ksarkies/Watermeter-TestBench/Documentation/Watermeter-Interface-Card.jpg

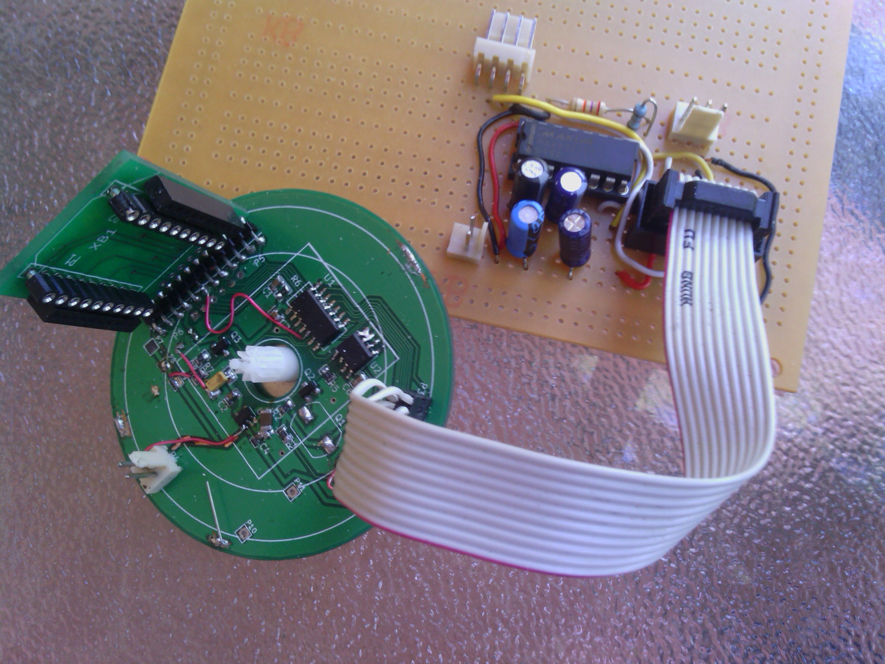
Documentation/Watermeter-Interface-Card.jpg
