ksarkies/Watermeter-TestBench/Documentation/MAX31865-Arduino-Connection.jpg

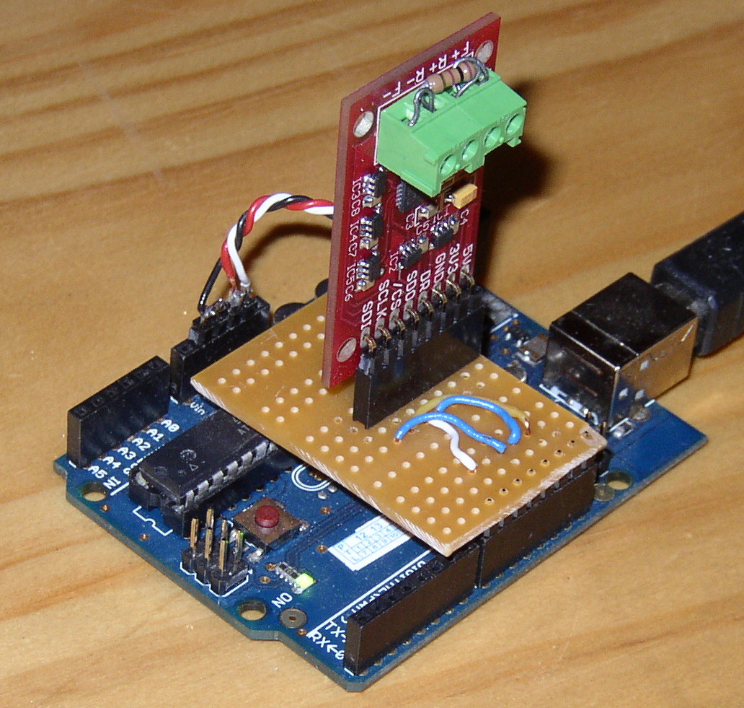
Documentation/MAX31865-Arduino-Connection.jpg
