ksarkies/Watermeter-TestBench/flowbench-firmware-Arduino/README.md

Watermeter Testbench Firmware
=============================

This is the Arduino firmware for the testbench experiments.

* Flow meter FS200A, 450 counts/litre, 25 litres/minute max, pulse rate 188Hz max.
Connect three pin plug (black = gnd, red = 5V, white = signal) to header 3 of
the Arduino Sensor Shield.

* Pressure sensor unknown. 0.5V - 4.5V for 0MPa - 1.2MPa.
Connect three pin plug (black = gnd, red = 5V, white = signal) to header A0 of
the Arduino Sensor Shield.

* Temperature sensor PT50 platinum wire plus bridge to current loop 4-20mA.
Connect grounds and two signal wires to the MAX31865 board. 

* Start switch normally high, momentarily low.
Connect three pin plug (black = gnd, red = 5V, white = signal) to header 4 of
the Arduino Sensor Shield.

* Solenoid 2W-200-20 high is off, low is on.
Connect three pin plug (black = gnd, red = 5V, white = signal) to header 5 of
the Arduino Sensor Shield.

* Water meter.
Connect three pin plug (black = gnd, red = 5V, white = signal) to header 6 of
the Arduino Sensor Shield.

K. Sarkies, 26/2/2015
