ksarkies/Watermeter-TestBench/Documentation/Arduino.jpg

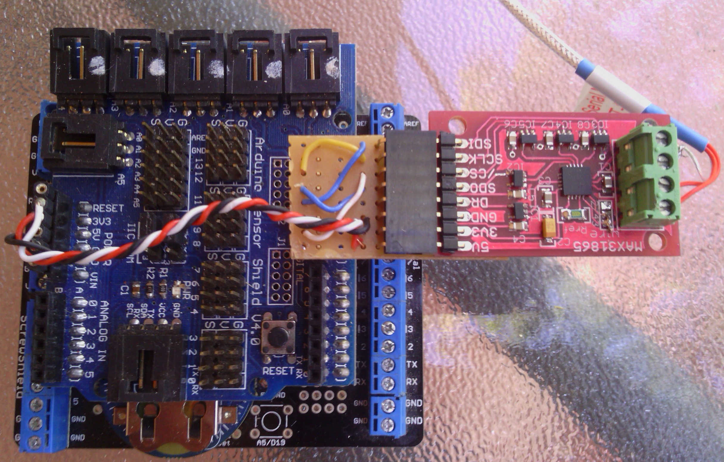
Documentation/Arduino.jpg
