ksarkies/Watermeter-TestBench/Documentation/flowbench-gui-1.png

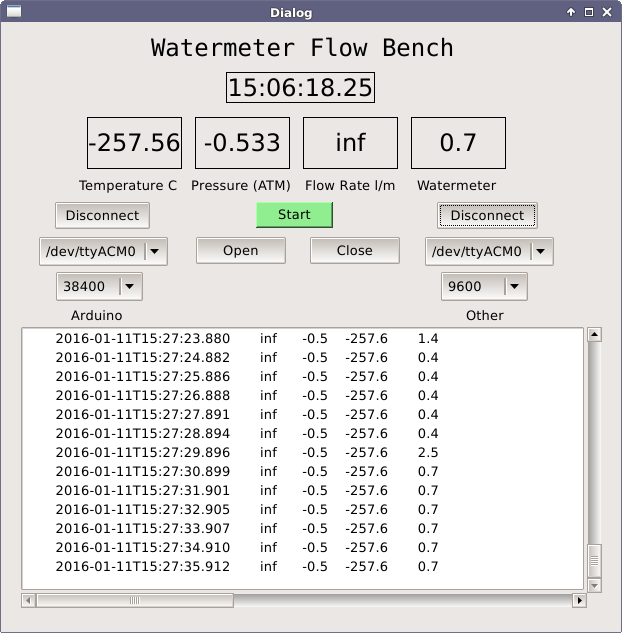
Documentation/flowbench-gui-1.png
