ksarkies/Watermeter-TestBench/Documentation/interface-card-bottom.jpg

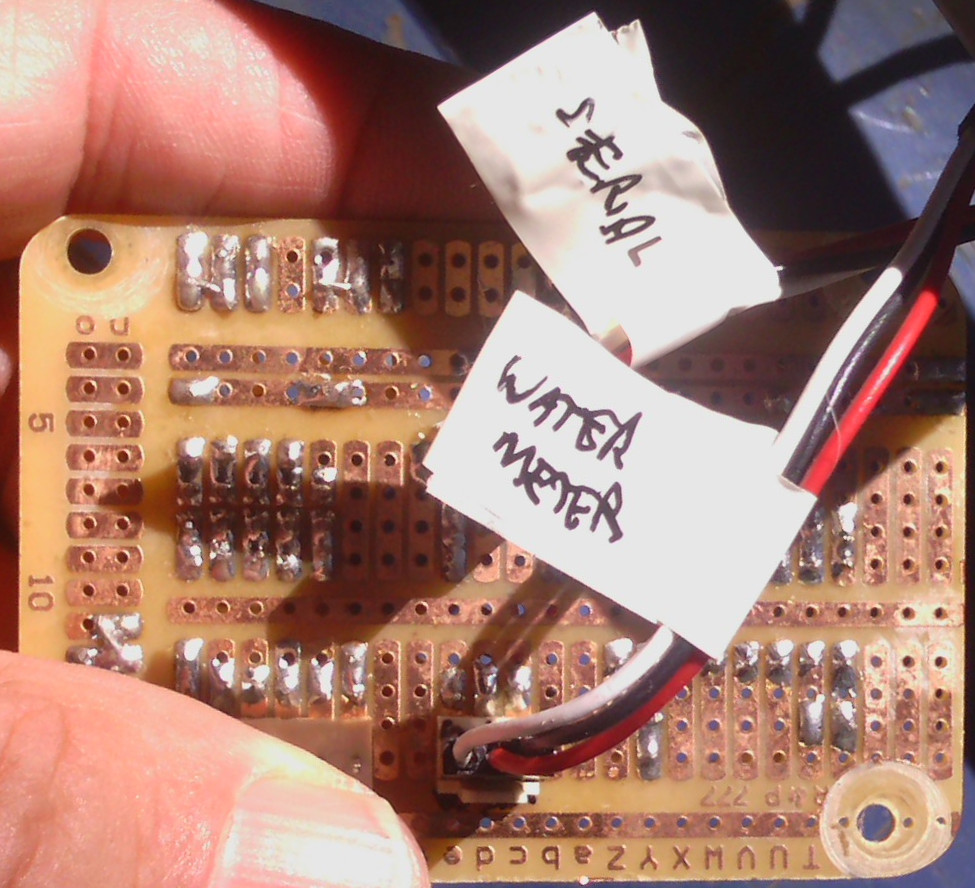
Documentation/interface-card-bottom.jpg
