ksarkies/Watermeter-TestBench/Documentation/interface-card-top.jpg

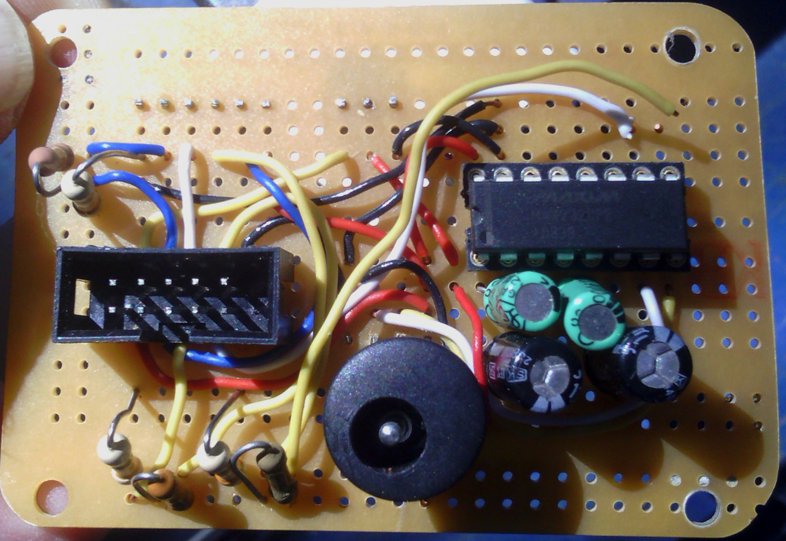
Documentation/interface-card-top.jpg
