ksarkies/Watermeter-TestBench/flowbench-pc-qt5/gui.png

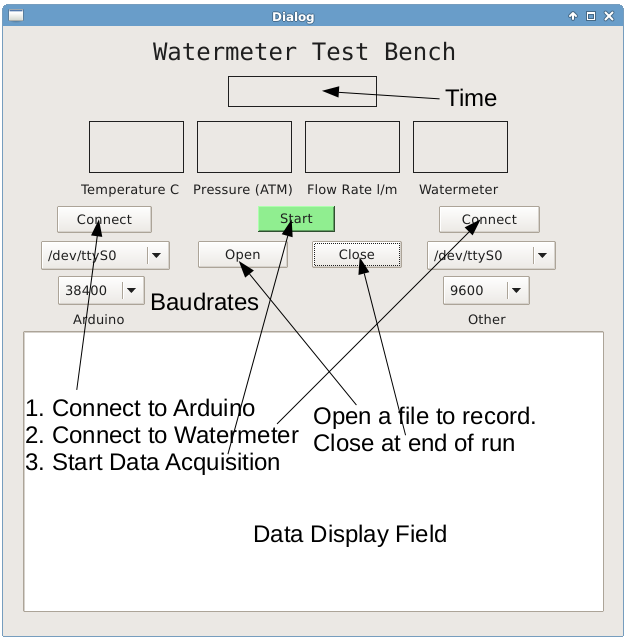
flowbench-pc-qt5/gui.png
