ksarkies/Watermeter-TestBench/flowbench-pc-qt5/BUILD.md

Watermeter Testbench GUI
========================

This has been designed for Linux only. Instructions are for a standard UBUNTU
installation.

1. Install qt4-designer and qt5-qmake and also under Ubuntu install
libqt5serialport5-dev and libudev-dev to ensure that all libraries are present.
3. In a terminal, change to the Testbench GUI directory and issue the commands:

   $ qmake
   $ make

K. Sarkies, 26/1/2016
