ksarkies/Watermeter-TestBench/gEDA-Test-Interfaces/README.md

Watermeter Interface Board
==========================

This is an interface board to provide interconnections to the watermeter
board for:

* Program load to the on-board AVR.
* Access to digitised optical pulses.
* Provide power to the board.
* Access to 9600 baud serial transmissions via an RS-232 level translator.

The circuit is drawn using gEDA schematic editor.

K. Sarkies, 26/01/2016
