ksarkies/Watermeter-TestBench/gEDA-Test-Interfaces/Test-Interfaces.png

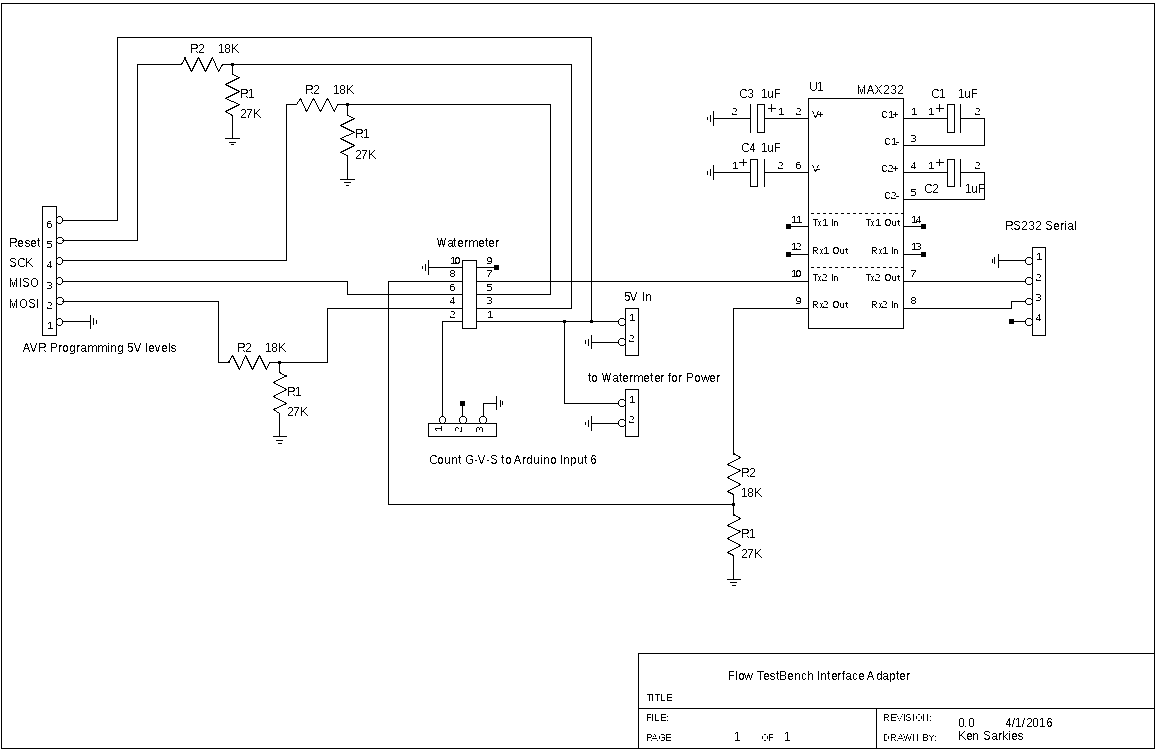
gEDA-Test-Interfaces/Test-Interfaces.png
