ksarkies/Watermeter-TestBench/(commit log)

2015-01-22 Create all-inclusive flowbench program. Flowmeter and pressure sensor only.
2015-01-23 Flowbench program now handling all sensors except the test watermeter.
2015-01-29 Flowbench provides ISO time plus ms fractions, plus all sensor values in csv format.
2015-02-19 Add features to firmware to compute period of flow meter.
2015-02-26 Add serial command receive and add command to turn switch on and off.
2015-03-26 Add serial port as an extra and change default baudrates to match current system.
2015-04-28 Add MAX31865 RT100 temperature module code instead of A/D conversion.
2016-01-26 Remove the test MAX31865 code. Add Interface board. Update README and BUILD files.
    [Test-Interfaces.sch]
2016-01-28 Change names from testbench to flowbench
2016-02-14 Add qt5 directory to change over to QT5 and QSerialPort. Update to manual. Change name of firmware-Arduino.ino to match directory name (as demanded unreasonably by Arduino IDE).
2016-02-14 Complete manual with flowbench GUI install procedure
